bearjhartjen/Lamoka1-DEV-Brain/Images/lamoka1-dev-brain-render-iso.png

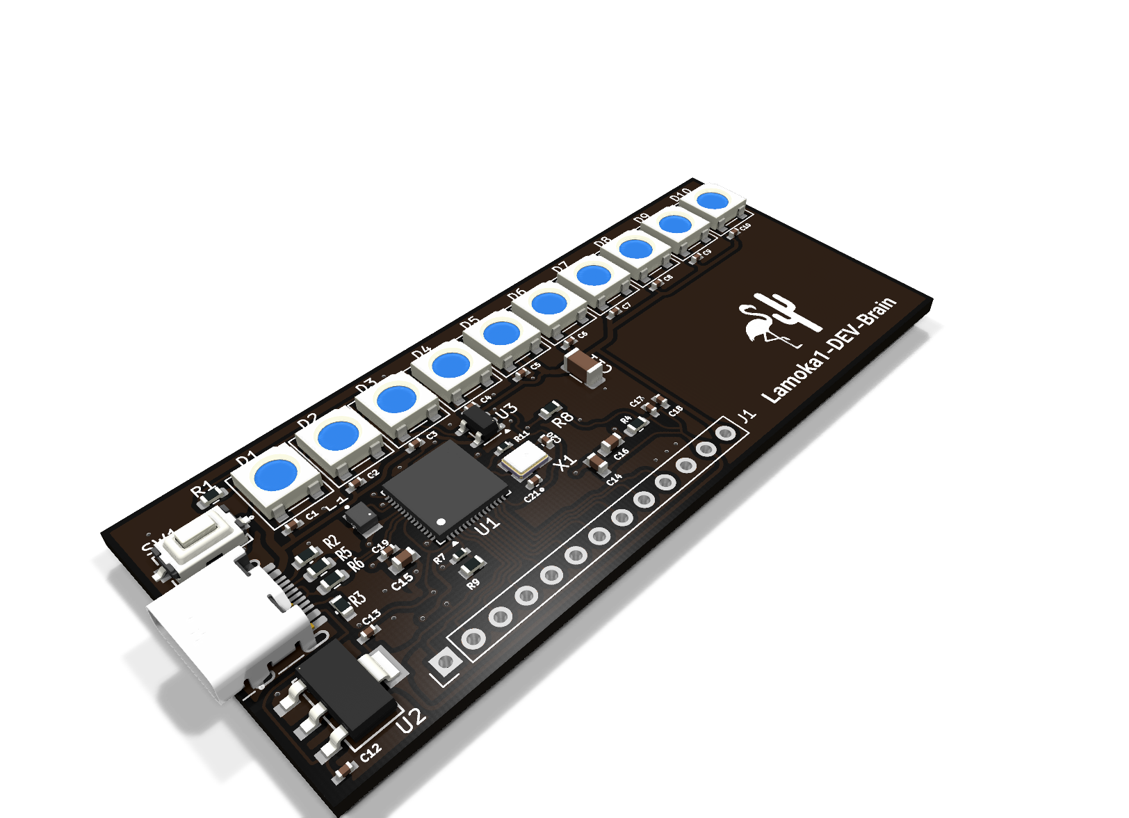
Images/lamoka1-dev-brain-render-iso.png
