bearjhartjen/Lamoka1-DEV-Brain/Images/lamoka1-dev-brain-render-top.png

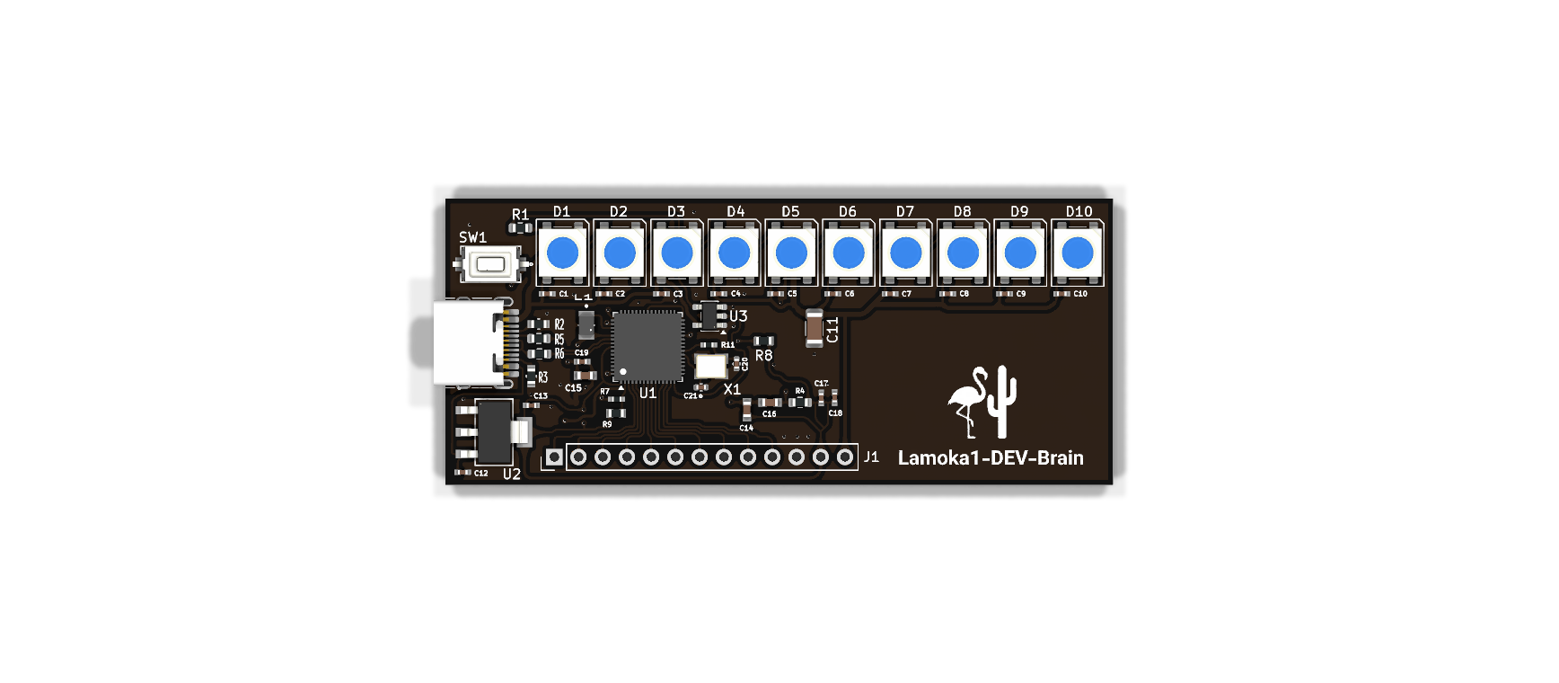
Images/lamoka1-dev-brain-render-top.png
