bearjhartjen/Lamoka1-DEV-Brain/HARDWARE/Lamoka1-DEV-Brain fab files/PCBway files/T-1N4W1065266A-1units-Lamoka1-DEV-board+BOM(2026-07-15).xls

PCBWay Bom Quotation, Product No.:T-1N4W1065266A
Item # | *Designator | *Qty | Manufacturer | *Mfg Part # | Description / Value | *Package/Footprint | Category | *Unit Price(1 unit) | *Total | *Delivery Time | *Actual Purchase Mfg Part # | *PCBWay Note | Customer Reply | PCBWay Update
1 | C1,C2,C3,C4,C5,C6,C7,C8,C9,C10,C17,C18,C19 | 13 | Samsung Electro-Mechanics | CL05B104KO5NNNC | 100 nF ceramic capacitor | 0402 | SMT | $0.021 | $0.273 |  | CL05B104KO5NNNC
2 | C11 | 1 | Murata Electronics | GRM31CR61A107MEA8K | 100 uF ceramic capacitor | 1206 | SMT | $2.265 | $2.265 |  | GRM31CR61A107MEA8K
3 | C12,C13 | 2 | Samsung Electro-Mechanics | CL05A106MQ5NUNC | 10 uF ceramic capacitor | 0402 | SMT | $0.405 | $0.810 |  | CL05A106MQ5NUNC
4 | C14,C15,C16 | 3 | Samsung Electro-Mechanics | CL10A475KP8NNNC | 4.7 uF ceramic capacitor | 0603 | SMT | $0.165 | $0.495 |  | CL10A475KP8NNNC
5 | C20,C21 | 2 | FH | 0402CG150J500NT | 15 pF C0G/NP0 ceramic capacitor | 0402 | SMT | $0.564 | $1.128 |  | 0402CG150J500NT
6 | D1,D2,D3,D4,D5,D6,D7,D8,D9,D10 | 10 | TUOZHAN | TZ-5050S2RGB-5V-I4-H1 | 5 V addressable RGB LED, WS2812B-compatible | 5050-4P | SMT | $0.071 | $0.710 |  | TZ-5050S2RGB-5V-I4-H1
7 | J3 | 1 | HRO Electronics | TYPE-C-31-M-12 | USB Type-C receptacle, USB 2.0 | HRO TYPE-C-31-M-12 | SMT / mechanical THT tabs | $1.110 | $1.110 |  | TYPE-C-31-M-12
8 | L1 | 1 | Abracon | AOTA-B201610S3R3-101-T | 3.3 uH power inductor | 2016 / 0806 | SMT | $0.688 | $0.688 | 7-10 Workdays | AOTA-B201610S3R3-101-T
9 | R1 | 1 | YAGEO | RC0603FR-07330RL | 330 ohm 1% resistor | 0603 | SMT | $0.457 | $0.457 | 7-10 Workdays | RC0603FR-07330RL
10 | R2,R3 | 2 | YAGEO | RC0603FR-075K1L | 5.1 kohm 1% resistor | 0603 | SMT | $0.054 | $0.108 |  | RC0603FR-075K1L
11 | R4 | 1 | YAGEO | RC0603FR-0733RL | 33 ohm 1% resistor | 0603 | SMT | $0.735 | $0.735 | 7-10 Workdays | RC0603FR-0733RL
12 | R5,R6 | 2 | YAGEO | RC0603FR-0727RL | 27 ohm 1% resistor | 0603 | SMT | $0.027 | $0.054 |  | RC0603FR-0727RL
13 | R7,R11 | 2 | YAGEO | RC0402FR-071KL | 1 kohm 1% resistor | 0402 | SMT | $0.147 | $0.294 |  | RC0402FR-071KL
14 | R8,R9 | 2 | YAGEO | RC0603FR-0710KL | 10 kohm 1% resistor | 0603 | SMT | $0.153 | $0.306 |  | RC0603FR-0710KL
15 | SW1 | 1 | C&K | PTS636SM43JSMTR LFS | Momentary tactile switch | PTS636 SMD | SMT | $0.812 | $0.812 | 7-10 Workdays | PTS636SM43JSMTR LFS
16 | U1 | 1 | Raspberry Pi | SC1511-A4 | RP2354A microcontroller | QFN-60 7x7 mm, 0.4 mm pitch, exposed pad | SMT / QFN | $1.719 | $1.719 | 7-10 Workdays | SC1511-A4
17 | U2 | 1 | EVVO | AMS1117-3.3 | 3.3 V linear regulator | SOT-223 | SMT | $0.937 | $0.937 | 7-10 Workdays | AMS1117-3.3 | AMS1117-3.3（5272-AMS1117-3.3CT-ND），Brand : EVVO Footprint ：SOT-223-3L ，pls confirm datasheet.
18 | U3 | 1 | Texas Instruments | SN74AHCT1G125DBVR | Single bus buffer / level shifter | SOT-23-5 | SMT | $0.138 | $0.138 |  | SN74AHCT1G125DBVR
19 | X1 | 1 | Abracon LLC | ABM8-272-T3 | Crystal resonator | SMD 3225-4P | SMT | $1.621 | $1.621 |  | ABM8-272-T3
 |  |  |  |  |  |  |  | Component Cost | $14.66
 |  |  |  |  |  |  |  | Assembly Cost | $29.00
 |  |  |  |  |  |  |  | PCB Cost | $5.00
 |  |  |  |  |  |  |  | V0 Member 0% off | $0.00
 |  |  |  |  |  |  |  | All Total 1 Units | $48.66
