bearjhartjen/Lamoka1-DEV-Brain/HARDWARE/Mechanical/Lamoka1-DEV-Brain_P1S_0.4mm_colored.obj

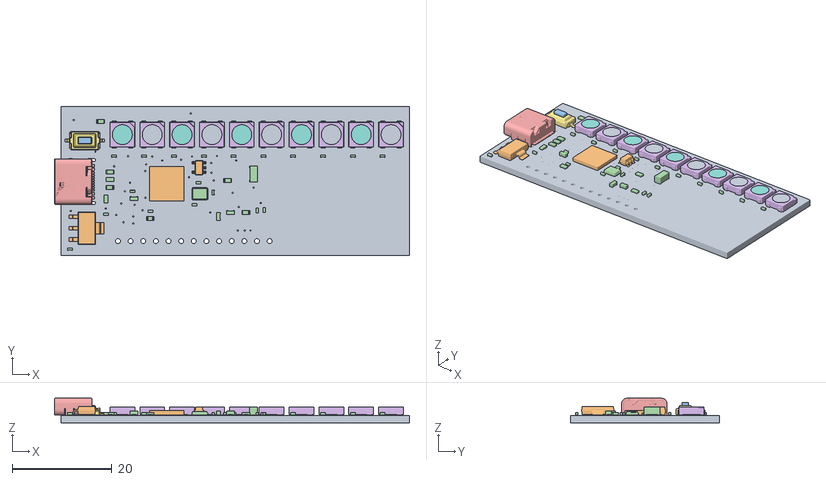
[picture p8: CAD file, 2026-11-11]
HARDWARE/Mechanical/Lamoka1-DEV-Brain_P1S_0.4mm_colored.obj
71.3 x 30.0 x 4.94
board
mcu_black
button_cap
others
usb
led_housing
button_base
led_die_purple
led_die_yellow
