bearjhartjen/Lamoka1-DEV-Brain/HARDWARE/Kicad files/Lamoka1-DEV-board.kicad_pcb

## KiCad design HARDWARE/Kicad files/Lamoka1-DEV-board.kicad_pcb (2026-11-02)

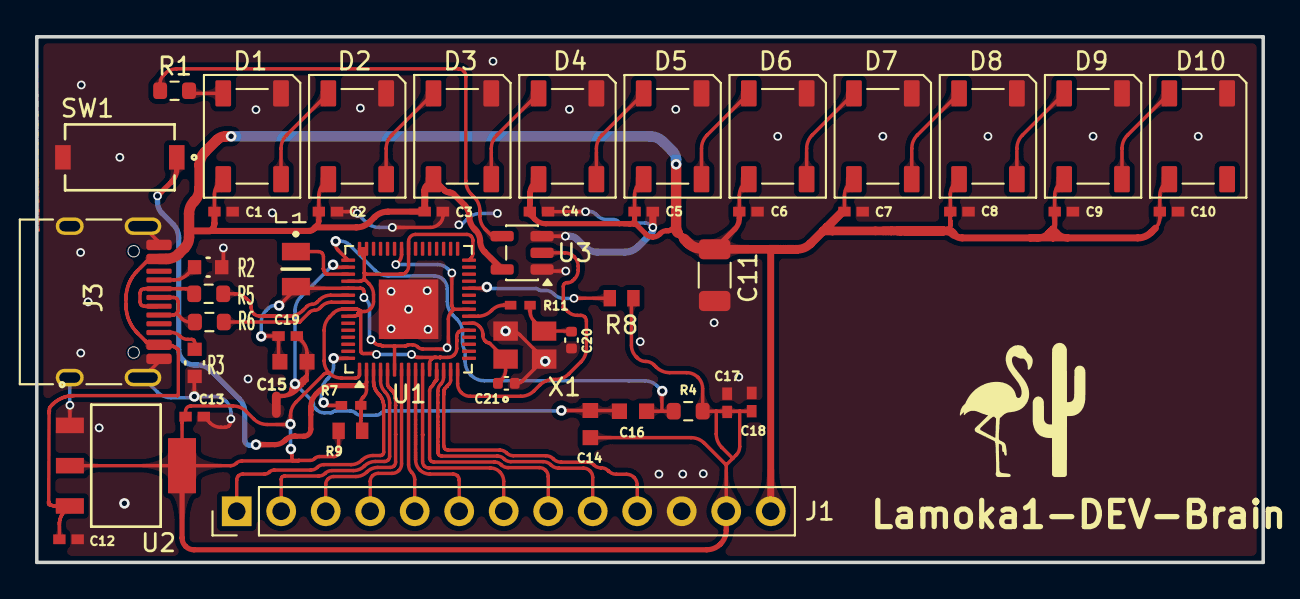
[picture p9: board Lamoka1-DEV-board.kicad_pcb from above]

Board: 2 copper layers, 70.0 x 30.0 mm, 50 parts (0 on the bottom side), 41 nets.

Parts:
C1, C2, C3, C4, C5, C6, C7, C8, C9, C10, C17, C18, C19: 100n; CAP_0402_SAM
C11: 100u; C_1206_3216Metric
C12, C13: 10u; CAP_CL_05_SAM
C14, C15, C16: 4.7u; CAP_0603_CL10A_1P6XP8_SAM
C20, C21: 15p; C_0402_1005Metric
D1, D2, D3, D4, D5, D6, D7, D8, D9, D10: WS2812B; LED_WS2812B_PLCC4_5.0x5.0mm_P3.2mm
J1: Conn_01x13_Pin; PinHeader_1x13_P2.54mm_Vertical
J3: USB_C_Receptacle_USB2.0_14P; USB_C_Receptacle_HRO_TYPE-C-31-M-12
L1: 3.3u; AOTAB201610S3R3101T
NT1: NetTie_2; NetTie-2_SMD_Pad0.5mm
R1: 330; R_0603_1608Metric
R2, R3: 5.1k; RC0603N_YAG
R4: 33; R_0603_1608Metric
R5, R6: 27; R_0603_1608Metric
R7, R11: 1k; RC0402N_PAN
R8, R9: 10k; RES_CRCW_0603
SW1: PTS636 SM43J SMTR LFS; SW_PTS636_CNK
U1: RP2354A; QFN-60-1EP_7x7mm_P0.4mm_EP3.4x3.4mm
U2: AMS1117-3.3; SOT-223_UMW
U3: 74AHCT1G125; SOT-23-5
X1: ABM8-272-T3; ABM8-272-T3_ABR

Connections:
/1V1: C15.1, C19.1, L1.2, U1.6 (DVDD), U1.23 (DVDD), U1.39 (DVDD), U1.50 (VREG_FB)
/3V3: C13.1, C14.1, C17.1, C18.1, J1.12, R4.1, R8.1, R9.1, U1.1 (IOVDD), U1.11 (IOVDD), U1.20 (IOVDD), U1.30 (IOVDD), U1.38 (IOVDD), U1.44 (ADC_AVDD), U1.45 (IOVDD), U1.49 (VREG_VIN), U1.53 (USB_OTP_VDD), U1.54 (QSPI_IOVDD), U2.2 (VOUT), U2.4 (VOUT)
/5V: C1.1, C2.1, C3.1, C4.1, C5.1, C6.1, C7.1, C8.1, C9.1, C10.1, C11.1, C12.2, D1.1 (VDD), D2.1 (VDD), D3.1 (VDD), D4.1 (VDD), D5.1 (VDD), D6.1 (VDD), D7.1 (VDD), D8.1 (VDD), D9.1 (VDD), D10.1 (VDD), J1.13, J3.A4 (VBUS), J3.A9 (VBUS), J3.B4 (VBUS), J3.B9 (VBUS), U2.3 (VIN), U3.5 (VCC)
/BTN: R7.1, R9.2, SW1.1, U1.2 (GPIO0)
/GPIO1: J1.1, U1.3 (GPIO1)
/GPIO2: J1.2, U1.4 (GPIO2)
/GPIO3: J1.3, U1.5 (GPIO3)
/GPIO4: J1.4, U1.7 (GPIO4)
/GPIO5: J1.5, U1.8 (GPIO5)
/GPIO6: J1.6, U1.9 (GPIO6)
/GPIO7: J1.7, U1.10 (GPIO7)
/GPIO8: J1.8, U1.12 (GPIO8)
/GPIO9: J1.9, U1.13 (GPIO9)
/GPIO10: J1.10, U1.14 (GPIO10)
/USB_DM: R5.2, U1.51 (USB_DM)
/USB_DP: R6.2, U1.52 (USB_DP)
/VREG_GND: C14.2, C15.2, C16.2, C19.2, NT1.1, U1.47 (VREG_PGND)
/XIN: C21.1, U1.21 (XIN), X1.1
/XOUT: R11.2, U1.22 (XOUT)
GND: C1.2, C2.2, C3.2, C4.2, C5.2, C6.2, C7.2, C8.2, C9.2, C10.2, C11.2, C12.1, C13.2, C17.2, C18.2, C20.2, C21.2, D1.3 (VSS), D2.3 (VSS), D3.3 (VSS), D4.3 (VSS), D5.3 (VSS), D6.3 (VSS), D7.3 (VSS), D8.3 (VSS), D9.3 (VSS), D10.3 (VSS), J1.11, J3.A1 (GND), J3.A12 (GND), J3.B1 (GND), J3.B12 (GND), J3.SH (SHIELD), NT1.2, R2.2, R3.2, SW1.2, U1.61 (GND), U2.1 (GND), U3.1, U3.3 (GND), X1.2, X1.4
unnamed: C20.1, R11.1, X1.3
unnamed: D1.4 (DIN), R1.1
unnamed: D1.2 (DOUT), D2.4 (DIN)
unnamed: D2.2 (DOUT), D3.4 (DIN)
unnamed: D3.2 (DOUT), D4.4 (DIN)
unnamed: D4.2 (DOUT), D5.4 (DIN)
unnamed: D5.2 (DOUT), D6.4 (DIN)
unnamed: D6.2 (DOUT), D7.4 (DIN)
unnamed: D7.2 (DOUT), D8.4 (DIN)
unnamed: D8.2 (DOUT), D9.4 (DIN)
unnamed: D9.2 (DOUT), D10.4 (DIN)
unnamed: J3.A5 (CC1), R2.1
unnamed: J3.B5 (CC2), R3.1
unnamed: J3.A6 (D+), J3.B6 (D+), R6.1
unnamed: J3.A7 (D-), J3.B7 (D-), R5.1
unnamed: R1.2, U3.4
unnamed: U1.15 (GPIO11), U3.2
unnamed: R8.2, U1.26 (RUN)
unnamed: C16.1, R4.2, U1.46 (VREG_AVDD)
unnamed: L1.1, U1.48 (VREG_LX)
unnamed: R7.2, U1.60 (~QSPI_SS)
