bearjhartjen/Lamoka1-DEV-Brain/SOFTWARE/Portal Interface Engine/V1.8.ino

#include <Arduino.h>
#include <FastLED.h>
#include "pico/bootrom.h"

/*
 * ================================================================
 * LAMOKA1 DEV BRAIN — PORTAL INTERFACE ENGINE V1.8
 * ================================================================
 *
 * HOME
 * ----
 * 0 = BLUE STATUS BALL
 * 1 = FIREPLACE
 * 2 = LIGHTSABER
 * 3 = RAINBOW
 * 4 = GAMES
 * 5 = SETTINGS
 *
 * HOME COLORS
 * -----------
 * 0-3 = exact cactus green
 * 4   = games orange
 * 5   = settings blue
 *
 * CURSOR
 * ------
 * Every selected item is a steady hot pink (no pulse, no hue variation).
 * Cursors now remember the last selected item
 * (Games menu stays on Fireball after exit, etc.).
 *
 * DEFAULT IDLE
 * ------------
 * Blue bouncing status ball.
 *
 * FIREPLACE
 * ---------
 * Enhanced V1.8 realism:
 * - stronger organic wind + source drift
 * - multi-layer heat diffusion + rising
 * - height-aware cooling
 * - lively random licks + rising sparks
 * - richer palette (deep red → orange → yellow → white-hot)
 * - more dramatic tap / double-tap flares
 *
 * FIREBALL
 * --------
 * - D0 green target
 * - white projectile + hot/orange/red trail
 * - right-to-left travel
 * - tap exactly on target = catch
 * - catch → blast + binary score + speed-up
 * - miss → short red flash + immediate re-fire
 * - 3 lives, long-hold exits to Games menu (cursor stays on Fireball)
 *
 * LIGHTSABER
 * ----------
 * Never generates the exact same hue twice in a row.
 *
 * BRIGHTNESS
 * ----------
 * Hard floor = 6
 *
 * BOOTSEL
 * -------
 * reset_usb_boot(0, 0)
 *
 * RULE
 * ----
 * No min() / max() library calls anywhere.
 */

/* ================================================================
 * HARDWARE
 * ================================================================ */
#define LED_PIN           11
#define NUM_LEDS          10
#define BUTTON_PIN        0
#define COLOR_ENTROPY_PIN 5
#define ADC0              26
#define ADC1              27
#define ADC2              28
#define ADC3              29

#define DEFAULT_BRIGHTNESS 6
#define DEFAULT_SPEED      100
#define FRAME_MS           16
#define MENU_TIMEOUT_MS    16000UL

CRGB leds[NUM_LEDS];

/* ================================================================
 * COLORS
 * ================================================================ */
const CRGB COLOR_CACTUS   = CRGB(0, 90, 18);
const CRGB COLOR_HOT_PINK = CRGB(255, 40, 160);
const CRGB COLOR_GAMES    = CRGB(255, 90, 0);
const CRGB COLOR_SETTINGS = CRGB(0, 50, 100);

const CRGB FIRE_GREEN  = CRGB(0, 180, 40);
const CRGB FIRE_RED    = CRGB(150, 0, 0);
const CRGB FIRE_ORANGE = CRGB(255, 45, 0);
const CRGB FIRE_HOT    = CRGB(255, 130, 10);
const CRGB FIRE_WHITE  = CRGB(255, 255, 255);

/* ================================================================
 * ENUMERATIONS
 * ================================================================ */
enum Gesture : uint8_t {
  G_NONE,
  G_TAP,
  G_DOUBLE,
  G_HOLD,
  G_LONG_HOLD,
  G_VERY_LONG
};

enum UIState : uint8_t {
  UI_MODE,
  UI_MENU_MAIN,
  UI_MENU_GAMES,
  UI_MENU_SETTINGS,
  UI_BRIGHTNESS,
  UI_SPEED,
  UI_INFO,
  UI_IN_GAME,
  UI_SLEEP
};

/* ================================================================
 * GLOBAL SETTINGS
 * ================================================================ */
uint8_t globalBrightness = DEFAULT_BRIGHTNESS;
uint8_t globalSpeed      = DEFAULT_SPEED;

/* ================================================================
 * UI GLOBALS  (cursors now persist)
 * ================================================================ */
uint8_t mainCursor           = 0;
uint8_t gamesCursor          = 0;   // remembers last Games selection
uint8_t settingsCursor       = 0;   // remembers last Settings selection
uint8_t currentMainMode      = 0;
uint8_t settingsReturnCursor = 0;
uint32_t menuLastActivity    = 0;
UIState uiState              = UI_MODE;

/* ================================================================
 * LED HELPERS
 * ================================================================ */
void applyBrightness() {
  uint8_t b = globalBrightness;
  if (b < 6) b = 6;
  FastLED.setBrightness(b);
}

void clearLeds() {
  fill_solid(leds, NUM_LEDS, CRGB::Black);
}

CRGB blendColor(const CRGB &a, const CRGB &b, uint8_t amount) {
  return CRGB(
    lerp8by8(a.r, b.r, amount),
    lerp8by8(a.g, b.g, amount),
    lerp8by8(a.b, b.b, amount)
  );
}

void renderCursor(uint8_t index) {
  if (index >= NUM_LEDS) return;
  // The cursor is a fixed hot pink, always: no hue variation and no
  // brightness breathing.  A drifting pink reads as a system bug, and
  // selection must never look like a fault.
  leds[index] = COLOR_HOT_PINK;
}

/* ================================================================
 * ENTROPY SERVICE
 * ================================================================ */
class EntropyService {
  uint32_t s = 1;

  void mix() {
    uint32_t a = analogRead(ADC0);
    uint32_t b = analogRead(ADC1);
    uint32_t c = analogRead(ADC2);
    uint32_t d = analogRead(ADC3);
    s ^= (a << 16);
    s ^= b;
    s ^= (c << 8);
    s ^= d;
    s ^= micros();
    s ^= ((uint32_t)digitalRead(COLOR_ENTROPY_PIN) << 23);
    s ^= s << 13;
    s ^= s >> 17;
    s ^= s << 5;
    s += 0x9E3779B9UL;
  }

public:
  void begin() {
    pinMode(ADC0, INPUT);
    pinMode(ADC1, INPUT);
    pinMode(ADC2, INPUT);
    pinMode(ADC3, INPUT);
    pinMode(COLOR_ENTROPY_PIN, INPUT);
    s ^= micros();
    for (uint16_t i = 0; i < 300; i++) mix();
  }

  void update() { mix(); }

  uint32_t next() {
    mix();
    s ^= s << 13;
    s ^= s >> 17;
    s ^= s << 5;
    return s;
  }

  uint8_t next8() { return (uint8_t)(next() & 255UL); }

  uint16_t range(uint16_t maximum) {
    if (maximum == 0) return 0;
    return (uint16_t)(next() % ((uint32_t)maximum + 1UL));
  }

  bool coin() { return (next() & 1UL) != 0; }
};

EntropyService entropy;

/* ================================================================
 * BUTTON SERVICE
 * ================================================================ */
class ButtonService {
  bool lastRaw         = HIGH;
  bool wasPressed      = false;
  bool pendingTap      = false;
  bool holdFired       = false;
  bool longFired       = false;
  bool veryLongFired   = false;
  uint32_t pressStart  = 0;
  uint32_t debounceStart = 0;
  uint32_t lastTap     = 0;

public:
  void begin() {
    pinMode(BUTTON_PIN, INPUT_PULLUP);
    lastRaw = digitalRead(BUTTON_PIN);
    debounceStart = millis();
  }

  Gesture poll(bool inMenu) {
    bool raw = digitalRead(BUTTON_PIN);
    uint32_t now = millis();

    if (raw != lastRaw) {
      debounceStart = now;
      lastRaw = raw;
    }
    if (now - debounceStart < 28) return G_NONE;

    bool pressed = !raw;

    if (pressed && !wasPressed) {
      wasPressed = true;
      pressStart = now;
      holdFired = longFired = veryLongFired = false;
      return G_NONE;
    }

    if (pressed) {
      uint32_t held = now - pressStart;
      if (held >= 2800 && !veryLongFired) {
        veryLongFired = true;
        return G_VERY_LONG;
      }
      if (held >= 1200 && !longFired) {
        longFired = true;
        return G_LONG_HOLD;
      }
      if (held >= 550 && !holdFired) {
        holdFired = true;
        return G_HOLD;
      }
    }

    if (!pressed && wasPressed) {
      wasPressed = false;
      uint32_t held = now - pressStart;
      if (!holdFired && !longFired && !veryLongFired && held < 400) {
        if (inMenu) return G_TAP;
        if (lastTap && now - lastTap < 380) {
          lastTap = 0;
          pendingTap = false;
          return G_DOUBLE;
        }
        lastTap = now;
        pendingTap = true;
      }
    }

    if (!inMenu && pendingTap && lastTap && now - lastTap >= 380) {
      pendingTap = false;
      return G_TAP;
    }

    return G_NONE;
  }
};

ButtonService button;

/* ================================================================
 * BASE MODE
 * ================================================================ */
class Mode {
public:
  virtual ~Mode() {}
  virtual void enter() {}
  virtual void update(Gesture) {}
  virtual void render() {}
};

/* ================================================================
 * STATUS — BLUE BOUNCING BALL
 * ================================================================ */
class ModeStatus : public Mode {
  int8_t p = 0;
  int8_t d = 1;
  uint32_t last = 0;

public:
  void enter() override {
    p = 0;
    d = 1;
    last = millis();
  }

  void render() override {
    clearLeds();
    uint16_t iv = (uint16_t)(28 + 8000 / (globalSpeed + 50));
    if (millis() - last >= iv) {
      last = millis();
      p += d;
      if (p >= NUM_LEDS - 1) { p = NUM_LEDS - 1; d = -1; }
      if (p <= 0) { p = 0; d = 1; }
    }

    for (int t = 0; t < 3; t++) {
      int q = p - d * t;
      if (q >= 0 && q < NUM_LEDS) {
        leds[q] = CRGB(0, 25 + t * 35, 70 + t * 55);
      }
    }
    leds[p] = CRGB(0, 70, 255);
  }
};

/* ================================================================
 * FIREPLACE — V1.8 REALISTIC UPGRADE
 * ================================================================ */
class ModeFire : public Mode {
  uint8_t heat[10];
  int16_t source = 4;
  int16_t target = 4;
  int8_t  sourceVel = 0;
  uint32_t lastMove = 0;
  uint8_t flare = 0;

  void chooseTarget() {
    // Prefer mid-low positions for natural fire base
    target = (int16_t)(1 + entropy.range(6));
  }

public:
  void enter() override {
    memset(heat, 0, sizeof(heat));
    source = target = 4;
    sourceVel = 0;
    lastMove = millis();
    flare = 0;
    for (uint8_t i = 0; i < NUM_LEDS; i++) {
      heat[i] = (uint8_t)(30 + entropy.range(50));
    }
  }

  void update(Gesture g) override {
    if (g == G_TAP) {
      flare = 160;
    }
    if (g == G_DOUBLE) {
      flare = 240;
      chooseTarget();
      sourceVel = (int8_t)(entropy.range(5) - 2);
    }
  }

  void render() override {
    uint32_t now = millis();

    // Organic source movement with velocity damping
    if (now - lastMove > 180UL + entropy.range(220)) {
      chooseTarget();
      lastMove = now;
      sourceVel = (int8_t)(entropy.range(3) - 1);
    }

    // Smooth source + light velocity
    if (source < target) source++;
    else if (source > target) source--;
    source += sourceVel;
    if (source < 1)  { source = 1;  sourceVel = 0; }
    if (source > 8)  { source = 8;  sourceVel = 0; }
    if (sourceVel) sourceVel = sourceVel > 0 ? sourceVel - 1 : sourceVel + 1;

    // Multi-octave wind
    uint8_t wind1 = inoise8(now / 70);
    uint8_t wind2 = inoise8(now / 140 + 50);
    int8_t drift = (int8_t)(((int)wind1 - 128) / 28 + ((int)wind2 - 128) / 40);

    // Height-aware cooling (hotter at base, cooler higher)
    for (uint8_t i = 0; i < NUM_LEDS; i++) {
      uint8_t cooling = (uint8_t)(2 + entropy.range(3) + (i * 3) / 8);
      heat[i] = heat[i] > cooling ? heat[i] - cooling : 0;
    }

    // Source injection with organic fuel
    int16_t rawSource = source + drift;
    if (rawSource < 0) rawSource = 0;
    if (rawSource > NUM_LEDS - 1) rawSource = NUM_LEDS - 1;
    uint8_t sourcePos = (uint8_t)rawSource;

    uint8_t fuel = (uint8_t)(120 + entropy.range(70) + (flare ? 40 : 0));
    heat[sourcePos] = qadd8(heat[sourcePos], fuel);
    if (sourcePos > 0) heat[sourcePos - 1] = qadd8(heat[sourcePos - 1], fuel / 2);
    if (sourcePos < NUM_LEDS - 1) heat[sourcePos + 1] = qadd8(heat[sourcePos + 1], fuel / 3);

    // Stronger diffusion
    uint8_t old[NUM_LEDS];
    memcpy(old, heat, sizeof(heat));
    for (uint8_t i = 1; i < NUM_LEDS - 1; i++) {
      uint16_t average = (uint16_t)old[i - 1] + (old[i] * 2) + old[i + 1];
      heat[i] = lerp8by8(old[i], (uint8_t)(average / 4), 160);
    }

    // Rising heat (stronger upward bias)
    for (int i = 9; i >= 1; i--) {
      uint16_t rising = (uint16_t)heat[i - 1] * 3 / 2;
      if (i >= 2) rising += heat[i - 2] / 2;
      heat[i] = lerp8by8(heat[i], (uint8_t)(rising > 255 ? 255 : rising), 180);
    }

    // Random flame licks + rising sparks
    if (entropy.next8() > 200) {
      int q = sourcePos + (int)entropy.range(4) - 1;
      if (q < 1) q = 1;
      if (q > 8) q = 8;
      uint8_t f = (uint8_t)(70 + entropy.range(120));
      heat[q] = qadd8(heat[q], f);
      if (q < 9) heat[q + 1] = qadd8(heat[q + 1], f / 2);
      if (q < 8 && entropy.coin()) heat[q + 2] = qadd8(heat[q + 2], f / 4);
    }

    // Occasional high spark
    if (entropy.next8() > 245) {
      uint8_t spark = (uint8_t)(5 + entropy.range(4));
      heat[spark] = qadd8(heat[spark], (uint8_t)(100 + entropy.range(80)));
    }

    // Dramatic flare decay
    if (flare) {
      heat[sourcePos] = qadd8(heat[sourcePos], flare);
      if (sourcePos < NUM_LEDS - 1) heat[sourcePos + 1] = qadd8(heat[sourcePos + 1], flare * 2 / 3);
      if (sourcePos < 8) heat[sourcePos + 2] = qadd8(heat[sourcePos + 2], flare / 3);
      flare = flare > 9 ? flare - 9 : 0;
    }

    // Force a living base glow
    if (heat[0] < 40) heat[0] = 40 + entropy.range(20);

    // Rich realistic palette
    for (uint8_t i = 0; i < NUM_LEDS; i++) {
      uint8_t noise = inoise8(now / 32 + i * 41);
      heat[i] = scale8(heat[i], (uint8_t)(210 + (noise >> 4)));
      uint8_t h = heat[i];

      if (h < 20) {
        leds[i] = blendColor(CRGB(4, 0, 0), CRGB(30, 1, 0), (uint8_t)(h * 12));
      } else if (h < 55) {
        leds[i] = blendColor(CRGB(30, 1, 0), CRGB(120, 8, 0),
                             scale8((uint8_t)(h - 20), 255));
      } else if (h < 100) {
        leds[i] = blendColor(CRGB(120, 8, 0), CRGB(255, 40, 0),
                             scale8((uint8_t)(h - 55), 255));
      } else if (h < 155) {
        leds[i] = blendColor(CRGB(255, 40, 0), CRGB(255, 140, 10),
                             scale8((uint8_t)(h - 100), 255));
      } else if (h < 210) {
        leds[i] = blendColor(CRGB(255, 140, 10), CRGB(255, 220, 60),
                             scale8((uint8_t)(h - 155), 255));
      } else {
        // White-hot core
        leds[i] = blendColor(CRGB(255, 220, 60), CRGB(255, 250, 200),
                             scale8((uint8_t)(h - 210), 255));
      }
    }
  }
};

/* ================================================================
 * LIGHTSABER — never same hue twice in a row
 * ================================================================ */
class ModeSaber : public Mode {
  uint8_t hue = 0;
  uint8_t lastHue = 255;          // force first launch to be different
  uint8_t sat = 220;
  uint8_t pattern = 0;
  uint8_t instability = 30;
  uint8_t power = 0;
  uint8_t clash = 0;
  bool extending = true;
  uint32_t ignition = 0;

  void launch() {
    // Guarantee a different hue from the previous blade
    do {
      hue = entropy.next8();
    } while (hue == lastHue);
    lastHue = hue;

    sat = (uint8_t)(175 + entropy.range(65));
    pattern = (uint8_t)entropy.range(6);
    instability = (uint8_t)(20 + entropy.range(80));
    power = 0;
    extending = true;
    ignition = millis();
  }

public:
  void enter() override { launch(); }

  void update(Gesture g) override {
    if (g == G_TAP) {
      if (extending) extending = false;
      else launch();
    }
    if (g == G_DOUBLE) launch();
    if (g == G_HOLD) clash = 16;
  }

  void render() override {
    clearLeds();
    uint8_t rate = (uint8_t)(7 + globalSpeed / 30);
    if (pattern == 1) rate += 4;
    if (pattern == 3 && rate > 2) rate--;

    if (extending) power = qadd8(power, rate);
    else           power = qsub8(power, 10);

    uint8_t len = scale8(power, 10);

    for (uint8_t i = 0; i < len; i++) {
      uint8_t b = qsub8(255, (uint8_t)(i * 11));

      if (pattern == 3 && entropy.next8() < instability) b = scale8(b, 120);
      if (pattern == 5 && entropy.next8() > 220)         b = 255;
      if (pattern == 4) b = scale8(b, beatsin8(12, 145, 255));
      if (pattern == 2) b = scale8(b, beatsin8(9, 185, 255));
      if (pattern == 1 && i == 0) b = 255;

      leds[i] = CHSV(hue, sat, b);
      if (i < 2) {
        leds[i] = blendColor(leds[i], CRGB::White, pattern == 1 ? 95 : 75);
      }
    }

    if (extending && millis() - ignition < 170 && len) {
      leds[0] = blendColor(leds[0], CRGB::White, 180);
    }

    if (clash) {
      for (uint8_t i = 0; i < len; i++) {
        if (entropy.next8() > 90) {
          leds[i] = blendColor(leds[i], CRGB::White, 210);
        }
      }
      clash--;
    }

    if (len && entropy.next8() > 220) {
      uint8_t p = entropy.next8() % len;
      leds[p] = blendColor(leds[p], CRGB::White, 150);
    }
  }
};

/* ================================================================
 * RAINBOW
 * ================================================================ */
class ModeRainbow : public Mode {
  uint8_t hue = 0;
  uint8_t spd = 3;
  bool rev = false;

public:
  void enter() override { hue = entropy.next8(); }

  void update(Gesture g) override {
    if (g == G_TAP)    spd = (uint8_t)(spd % 10 + 1);
    if (g == G_DOUBLE) rev = !rev;
  }

  void render() override {
    uint8_t s = (uint8_t)(spd * (globalSpeed + 40) / 75);
    if (!s) s = 1;
    if (rev) hue -= s;
    else     hue += s;
    fill_rainbow(leds, NUM_LEDS, hue, 16);
  }
};

/* ================================================================
 * MODE INSTANCES
 * ================================================================ */
ModeStatus  modeStatus;
ModeFire    modeFire;
ModeSaber   modeSaber;
ModeRainbow modeRainbow;

Mode* mainModes[] = {
  &modeStatus,
  &modeFire,
  &modeSaber,
  &modeRainbow
};
const uint8_t MAIN_MODE_COUNT = 4;

/* ================================================================
 * FIREBALL GAME
 * ================================================================ */
class AppFireball {
  static const int TARGET_LED  = 0;
  static const int START_SPEED = 115;
  static const int SPEEDUP     = 10;
  static const int MIN_SPEED   = 30;

  enum GameState : uint8_t {
    GAME_RUNNING,
    GAME_BLAST,
    GAME_SCORE,
    GAME_MISSED,
    GAME_OVER
  };

  GameState state        = GAME_RUNNING;
  uint16_t  score        = 0;
  uint8_t   lives        = 3;
  int       firePosition = NUM_LEDS - 1;
  int       fireSpeed    = START_SPEED;
  uint32_t  lastMove     = 0;
  uint32_t  stateStart   = 0;

  uint8_t displayedScore() const {
    return score > NUM_LEDS ? NUM_LEDS : (uint8_t)score;
  }

  void drawGame() {
    clearLeds();
    leds[TARGET_LED] = FIRE_GREEN;

    if (firePosition >= 0 && firePosition < NUM_LEDS) {
      leds[firePosition] = FIRE_WHITE;
    }
    if (firePosition + 1 < NUM_LEDS) leds[firePosition + 1] = FIRE_HOT;
    if (firePosition + 2 < NUM_LEDS) leds[firePosition + 2] = FIRE_ORANGE;
    if (firePosition + 3 < NUM_LEDS) leds[firePosition + 3] = FIRE_RED;
  }

  void beginRound() {
    firePosition = NUM_LEDS - 1;
    lastMove = millis();
    state = GAME_RUNNING;
  }

  void startBlast() {
    stateStart = millis();
    state = GAME_BLAST;
  }

  void catchFireball() {
    score++;
    fireSpeed -= SPEEDUP;
    if (fireSpeed < MIN_SPEED) fireSpeed = MIN_SPEED;
    startBlast();
  }

  void missFireball() {
    if (lives > 0) lives--;
    stateStart = millis();
    state = (lives == 0) ? GAME_OVER : GAME_MISSED;
  }

  void renderBlast() {
    clearLeds();
    uint32_t elapsed = millis() - stateStart;
    uint8_t frame = (uint8_t)(elapsed / 45UL);
    if (frame > 7) frame = 7;

    for (int i = 0; i < NUM_LEDS; i++) {
      int distance = abs(i - TARGET_LED);
      if (distance <= frame) {
        int level = 255 - distance * 50 - frame * 18;
        if (level < 10) level = 10;
        leds[i] = CRGB((uint8_t)level, (uint8_t)(level / 2), (uint8_t)(level / 12));
      }
    }
  }

  void renderScore() {
    clearLeds();
    uint8_t shown = displayedScore();
    for (uint8_t i = 0; i < NUM_LEDS; i++) {
      if (shown & (1U << i)) leds[i] = COLOR_CACTUS;
    }
  }

public:
  void enter() {
    score = 0;
    lives = 3;
    fireSpeed = START_SPEED;
    firePosition = NUM_LEDS - 1;
    lastMove = millis();
    state = GAME_RUNNING;
    stateStart = millis();
  }

  void update(Gesture g) {
    if (state == GAME_OVER) {
      if (g == G_TAP) enter();
      return;
    }
    if (state == GAME_BLAST || state == GAME_SCORE || state == GAME_MISSED) return;

    if (state == GAME_RUNNING && g == G_TAP) {
      if (firePosition == TARGET_LED) catchFireball();
    }
  }

  void render() {
    if (state == GAME_RUNNING) {
      uint32_t now = millis();
      if (now - lastMove >= (uint32_t)fireSpeed) {
        lastMove = now;
        firePosition--;
        if (firePosition < TARGET_LED) missFireball();
      }
      if (state == GAME_RUNNING) drawGame();
      return;
    }

    if (state == GAME_BLAST) {
      uint32_t elapsed = millis() - stateStart;
      renderBlast();
      if (elapsed >= 360) {
        state = GAME_SCORE;
        stateStart = millis();
      }
      return;
    }

    if (state == GAME_SCORE) {
      renderScore();
      if (millis() - stateStart >= 750) beginRound();
      return;
    }

    if (state == GAME_MISSED) {
      clearLeds();
      uint32_t elapsed = millis() - stateStart;
      if (elapsed < 70) fill_solid(leds, NUM_LEDS, FIRE_RED);
      if (elapsed >= 140) beginRound();
      return;
    }

    if (state == GAME_OVER) {
      clearLeds();
      uint8_t pulse = beatsin8(4, 30, 180);
      fill_solid(leds, NUM_LEDS, CRGB(pulse, 0, 0));
      uint8_t shown = displayedScore();
      for (uint8_t i = 0; i < NUM_LEDS; i++) {
        if (shown & (1U << i)) leds[i] = COLOR_CACTUS;
      }
    }
  }
};

AppFireball appFireball;

/* ================================================================
 * MENU HELPERS
 * ================================================================ */
void touchMenu() {
  menuLastActivity = millis();
}

bool inAnyMenu() {
  return uiState == UI_MENU_MAIN   ||
         uiState == UI_MENU_GAMES  ||
         uiState == UI_MENU_SETTINGS ||
         uiState == UI_BRIGHTNESS  ||
         uiState == UI_SPEED       ||
         uiState == UI_INFO;
}

/* ================================================================
 * HOME MENU
 * ================================================================ */
void renderMainMenu() {
  clearLeds();
  leds[0] = COLOR_CACTUS;
  leds[1] = COLOR_CACTUS;
  leds[2] = COLOR_CACTUS;
  leds[3] = COLOR_CACTUS;
  leds[4] = COLOR_GAMES;
  leds[5] = COLOR_SETTINGS;
  for (uint8_t i = 6; i < NUM_LEDS; i++) leds[i] = CRGB::Black;
  renderCursor(mainCursor);
}

/* ================================================================
 * GAMES MENU
 * ================================================================ */
void renderGamesMenu() {
  clearLeds();
  leds[0] = CRGB(255, 100, 0);   // Back
  leds[1] = CRGB(255, 0, 0);     // Fireball
  renderCursor(gamesCursor);
}

/* ================================================================
 * SETTINGS MENU
 * ================================================================ */
const uint8_t SETTINGS_COUNT = 6;

void renderSettingsMenu() {
  clearLeds();
  leds[0] = COLOR_SETTINGS;               // Back
  leds[1] = COLOR_CACTUS;                 // Brightness
  leds[2] = COLOR_CACTUS;                 // Speed
  leds[3] = COLOR_CACTUS;                 // Info
  leds[4] = CRGB(180, 120, 0);            // Bootsel
  leds[5] = CRGB(255, 0, 0);              // Shutdown
  renderCursor(settingsCursor);
}

/* ================================================================
 * BRIGHTNESS
 * ================================================================ */
const uint8_t brightVals[10] = {6, 12, 20, 30, 42, 56, 72, 88, 106, 125};
uint8_t brightLevel = 0;

void renderBrightness() {
  for (uint8_t i = 0; i < NUM_LEDS; i++) {
    leds[i] = (i <= brightLevel) ? COLOR_HOT_PINK : COLOR_CACTUS;
  }
}

/* ================================================================
 * SPEED
 * ================================================================ */
const uint8_t speedVals[10] = {40, 55, 70, 85, 100, 120, 145, 170, 200, 240};
uint8_t speedLevel = 4;

void renderSpeed() {
  for (uint8_t i = 0; i < NUM_LEDS; i++) {
    leds[i] = (i <= speedLevel) ? COLOR_HOT_PINK : COLOR_CACTUS;
  }
}

/* ================================================================
 * INFO
 * ================================================================ */
uint8_t infoPage = 0;

void renderInfo() {
  clearLeds();
  if (infoPage == 0) {
    fill_solid(leds, NUM_LEDS, COLOR_CACTUS);
    leds[0] = COLOR_HOT_PINK;
  } else if (infoPage == 1) {
    uint8_t n = (uint8_t)((millis() / 1000UL) % (NUM_LEDS + 1));
    for (uint8_t i = 0; i < NUM_LEDS; i++) {
      leds[i] = (i < n) ? COLOR_CACTUS : CRGB::Black;
    }
  } else {
    fill_solid(leds, NUM_LEDS, COLOR_CACTUS);
  }
}

/* ================================================================
 * SHUTDOWN
 * ================================================================ */
bool sleepWaitRelease = true;
uint32_t sleepStart = 0;

void enterShutdown() {
  uiState = UI_SLEEP;
  sleepWaitRelease = true;
  sleepStart = 0;
  clearLeds();
  FastLED.setBrightness(0);
  FastLED.show();
}

void updateShutdown() {
  clearLeds();
  FastLED.setBrightness(0);
  FastLED.show();

  if (sleepWaitRelease) {
    if (digitalRead(BUTTON_PIN) == HIGH) sleepWaitRelease = false;
    return;
  }

  if (digitalRead(BUTTON_PIN) == LOW) {
    if (!sleepStart) sleepStart = millis();
    if (millis() - sleepStart >= 1500) {
      sleepStart = 0;
      applyBrightness();
      uiState = UI_MODE;
      currentMainMode = 0;
      mainCursor = 0;
      modeStatus.enter();
      sleepWaitRelease = true;
    }
  } else {
    sleepStart = 0;
  }
}

/* ================================================================
 * BOOTSEL
 * ================================================================ */
void enterBootsel() {
  clearLeds();
  FastLED.setBrightness(0);
  FastLED.show();
  delay(40);
  reset_usb_boot(0, 0);
  while (true) delay(1000);
}

/* ================================================================
 * RETURN TO DEFAULT IDLE
 * ================================================================ */
void returnToIdle() {
  uiState = UI_MODE;
  currentMainMode = 0;
  mainCursor = 0;
  modeStatus.enter();
}

/* ================================================================
 * UI HANDLER
 * ================================================================ */
void handleUI(Gesture g) {
  if (g == G_NONE) return;
  if (inAnyMenu()) touchMenu();

  // Very-long → force idle
  if (g == G_VERY_LONG) {
    fill_solid(leds, NUM_LEDS, COLOR_HOT_PINK);
    FastLED.show();
    delay(120);
    returnToIdle();
    return;
  }

  // -------- FIREBALL --------
  if (uiState == UI_IN_GAME) {
    if (g == G_LONG_HOLD) {
      // Keep gamesCursor exactly where it was (Fireball)
      uiState = UI_MENU_GAMES;
      touchMenu();
      return;
    }
    appFireball.update(g);
    return;
  }

  // -------- NORMAL MODE --------
  if (uiState == UI_MODE) {
    if (g == G_HOLD) {
      mainCursor = currentMainMode;
      uiState = UI_MENU_MAIN;
      touchMenu();
      return;
    }
    if (g == G_LONG_HOLD) {
      returnToIdle();
      return;
    }
    mainModes[currentMainMode]->update(g);
    return;
  }

  // -------- HOME MENU --------
  if (uiState == UI_MENU_MAIN) {
    if (g == G_TAP) {
      mainCursor = (uint8_t)((mainCursor + 1) % 6);
      return;
    }
    if (g == G_DOUBLE) {
      mainCursor = (mainCursor == 0) ? 5 : mainCursor - 1;
      return;
    }
    if (g == G_HOLD) {
      switch (mainCursor) {
        case 0:
          currentMainMode = 0;
          modeStatus.enter();
          uiState = UI_MODE;
          return;
        case 1:
          currentMainMode = 1;
          modeFire.enter();
          uiState = UI_MODE;
          return;
        case 2:
          currentMainMode = 2;
          modeSaber.enter();
          uiState = UI_MODE;
          return;
        case 3:
          currentMainMode = 3;
          modeRainbow.enter();
          uiState = UI_MODE;
          return;
        case 4:
          // Do NOT reset gamesCursor — remember last selection
          uiState = UI_MENU_GAMES;
          touchMenu();
          return;
        case 5:
          // Do NOT reset settingsCursor — remember last selection
          uiState = UI_MENU_SETTINGS;
          touchMenu();
          return;
      }
    }
    if (g == G_LONG_HOLD) {
      returnToIdle();
      return;
    }
  }

  // -------- GAMES MENU --------
  if (uiState == UI_MENU_GAMES) {
    if (g == G_TAP) {
      gamesCursor = (uint8_t)((gamesCursor + 1) % 2);
      return;
    }
    if (g == G_DOUBLE) {
      gamesCursor = (gamesCursor == 0) ? 1 : 0;
      return;
    }
    if (g == G_HOLD) {
      if (gamesCursor == 0) {
        uiState = UI_MENU_MAIN;
        mainCursor = 4;
        touchMenu();
        return;
      }
      if (gamesCursor == 1) {
        appFireball.enter();
        uiState = UI_IN_GAME;
        touchMenu();
        return;
      }
    }
    if (g == G_LONG_HOLD) {
      uiState = UI_MENU_MAIN;
      mainCursor = 4;
      touchMenu();
      return;
    }
  }

  // -------- SETTINGS MENU --------
  if (uiState == UI_MENU_SETTINGS) {
    if (g == G_TAP) {
      settingsCursor = (uint8_t)((settingsCursor + 1) % SETTINGS_COUNT);
      return;
    }
    if (g == G_DOUBLE) {
      settingsCursor = (settingsCursor == 0) ? SETTINGS_COUNT - 1 : settingsCursor - 1;
      return;
    }
    if (g == G_HOLD) {
      if (settingsCursor == 0) {
        uiState = UI_MENU_MAIN;
        mainCursor = 5;
        touchMenu();
        return;
      }
      if (settingsCursor == 1) {
        settingsReturnCursor = 1;
        uint8_t best = 255;
        for (uint8_t i = 0; i < sizeof(brightVals); i++) {
          uint8_t difference = (uint8_t)abs((int)brightVals[i] - (int)globalBrightness);
          if (difference < best) {
            best = difference;
            brightLevel = i;
          }
        }
        uiState = UI_BRIGHTNESS;
        touchMenu();
        return;
      }
      if (settingsCursor == 2) {
        settingsReturnCursor = 2;
        uint8_t best = 255;
        for (uint8_t i = 0; i < sizeof(speedVals); i++) {
          uint8_t difference = (uint8_t)abs((int)speedVals[i] - (int)globalSpeed);
          if (difference < best) {
            best = difference;
            speedLevel = i;
          }
        }
        uiState = UI_SPEED;
        touchMenu();
        return;
      }
      if (settingsCursor == 3) {
        settingsReturnCursor = 3;
        infoPage = 0;
        uiState = UI_INFO;
        touchMenu();
        return;
      }
      if (settingsCursor == 4) {
        enterBootsel();
        return;
      }
      if (settingsCursor == 5) {
        enterShutdown();
        return;
      }
    }
    if (g == G_LONG_HOLD) {
      uiState = UI_MENU_MAIN;
      mainCursor = 5;
      touchMenu();
      return;
    }
  }

  // -------- BRIGHTNESS --------
  if (uiState == UI_BRIGHTNESS) {
    if (g == G_TAP) {
      brightLevel = (uint8_t)((brightLevel + 1) % 10);
      globalBrightness = brightVals[brightLevel];
      applyBrightness();
      touchMenu();
      return;
    }
    if (g == G_DOUBLE) {
      brightLevel = (brightLevel == 0) ? 9 : brightLevel - 1;
      globalBrightness = brightVals[brightLevel];
      applyBrightness();
      touchMenu();
      return;
    }
    if (g == G_HOLD || g == G_LONG_HOLD) {
      uiState = UI_MENU_SETTINGS;
      settingsCursor = settingsReturnCursor;
      touchMenu();
      return;
    }
  }

  // -------- SPEED --------
  if (uiState == UI_SPEED) {
    if (g == G_TAP) {
      speedLevel = (uint8_t)((speedLevel + 1) % 10);
      globalSpeed = speedVals[speedLevel];
      touchMenu();
      return;
    }
    if (g == G_DOUBLE) {
      speedLevel = (speedLevel == 0) ? 9 : speedLevel - 1;
      globalSpeed = speedVals[speedLevel];
      touchMenu();
      return;
    }
    if (g == G_HOLD || g == G_LONG_HOLD) {
      uiState = UI_MENU_SETTINGS;
      settingsCursor = settingsReturnCursor;
      touchMenu();
      return;
    }
  }

  // -------- INFO --------
  if (uiState == UI_INFO) {
    if (g == G_TAP) {
      infoPage = (uint8_t)((infoPage + 1) % 3);
      touchMenu();
      return;
    }
    if (g == G_DOUBLE) {
      infoPage = (infoPage == 0) ? 2 : infoPage - 1;
      touchMenu();
      return;
    }
    if (g == G_HOLD || g == G_LONG_HOLD) {
      uiState = UI_MENU_SETTINGS;
      settingsCursor = settingsReturnCursor;
      touchMenu();
      return;
    }
  }
}

/* ================================================================
 * RENDER UI
 * ================================================================ */
void renderUI() {
  switch (uiState) {
    case UI_MODE:          mainModes[currentMainMode]->render(); break;
    case UI_MENU_MAIN:     renderMainMenu();                     break;
    case UI_MENU_GAMES:    renderGamesMenu();                    break;
    case UI_MENU_SETTINGS: renderSettingsMenu();                 break;
    case UI_BRIGHTNESS:    renderBrightness();                   break;
    case UI_SPEED:         renderSpeed();                        break;
    case UI_INFO:          renderInfo();                         break;
    case UI_IN_GAME:       appFireball.render();                 break;
    case UI_SLEEP:         clearLeds();                          break;
  }
}

/* ================================================================
 * SETUP
 * ================================================================ */
void setup() {
  FastLED.addLeds<WS2812B, LED_PIN, GRB>(leds, NUM_LEDS);
  FastLED.setDither(0);
  applyBrightness();
  FastLED.clear(true);

  entropy.begin();
  button.begin();

  // Known-good startup sweep
  for (uint8_t i = 0; i < NUM_LEDS; i++) {
    leds[i] = CHSV(i * 25, 230, 210);
    FastLED.show();
    delay(18);
  }
  delay(70);
  clearLeds();
  FastLED.show();

  currentMainMode = 0;
  mainCursor = 0;
  uiState = UI_MODE;
  modeStatus.enter();
}

/* ================================================================
 * LOOP
 * ================================================================ */
void loop() {
  static uint32_t lastFrame = 0;
  uint32_t now = millis();

  if (uiState == UI_SLEEP) {
    updateShutdown();
    delay(5);
    return;
  }

  entropy.update();

  if (inAnyMenu() && now - menuLastActivity > MENU_TIMEOUT_MS) {
    returnToIdle();
  }

  Gesture g = button.poll(inAnyMenu() || uiState == UI_IN_GAME);
  if (g != G_NONE) handleUI(g);

  if (now - lastFrame >= FRAME_MS) {
    lastFrame = now;
    renderUI();
    FastLED.show();
  }
}
