bearjhartjen/Lamoka1-DEV-Brain/(commit log)

2026-10-27 Move all Lamoka1-DEV-Brain stuff here, for its own home base
    [Lamoka1-DEV-board BOM.csv, Lamoka1-DEV-board Pick and Place bottom.csv, Lamoka1-DEV-board Pick and Place top.csv, Lamoka1-DEV-board Pick and Place.csv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]
2026-10-29 Improve for consistency
    [Lamoka1-DEV-Brain.stl, Lamoka1-DEV-board BOM.csv, Lamoka1-DEV-board Pick and Place bottom.csv, Lamoka1-DEV-board Pick and Place top.csv, Lamoka1-DEV-board Pick and Place.csv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]
2026-10-30 ADD 3D model and such
    [Lamoka1-DEV-Brain_P1S_0.2mm_Component_Mended.3mf]
2026-10-31 README: enlarge board name and tighten the hero
    Crop the transparent canvas above and below the board, and put the title in the same heading as the image so it sits directly beneath it at heading size.
2026-11-02 HAL lead free copper for PCB renders
    [Lamoka1-DEV-board.kicad_pcb]
2026-11-03 ADD proper images for PCB renders
2026-11-11 ADD perfect 3d model
    [Lamoka1-DEV-Brain.stl, Lamoka1-DEV-Brain_P1S_0.2mm_Component_Mended.3mf, Lamoka1-DEV-Brain_P1S_0.4mm_colored.obj]
